psuieee/PoketPomodoro/BOM/BOM - Pomodoro Timer.csv

# | Item | Package Quantity | Quantity Used | Package Cost | Final Unit Cost | Link | Seller | Notes
1 | Attiny 85 | 10 | 1 | $34.00 | $3.40 | https://www.amazon.com/10Pair-ATtiny85-20PU-sockets-Flash-ATtiny85/dp/B0FCYW4XYV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
2 | 128x64 Oled Display | 3 | 1 | $10.00 | $3.33 | https://www.amazon.com/ELEGOO-Display-Compact-Self-Luminous-Projects/dp/B0D2RMQQHR
3 | DS3231 Compact RTC Module | 4 | 1 | $10.00 | $2.50 | https://www.amazon.com/Dorhea-DS3231-Module-Memory-Raspberry/dp/B08X4H3NBR
4 | Push Button | 120 | 5 | $7.00 | $0.29 | https://www.amazon.com/QTEATAK-Momentary-Tactile-Button-Switch/dp/B07VSNN9S2?cv_ct_cx=push%2Bbutton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
5 | Passive Buzzer | 10 | 1 | $4.00 | $0.40 | https://www.amazon.com/Shutao-Passive-Buzzer-12MMx9-5MM-Resistance/dp/B0GKNM192Y
6 | 2k ohm 1% tol resistor |  | 4 |  |  |  |  | Stockroom
7 | 10k ohm 1% tol resistor |  | 1 |  |  |  |  | Stockroom
8 | AAA Battery | 36 | 3 | $13.70 | $1.14 | https://www.amazon.com/Amazon-Basics-AAA-High-Performance-36/dp/B00LH3DMUO
9 | Keystone Battery contacts | 12 | 3 | $5.49 | $1.37 | https://www.amazon.com/Contacts-Negative-Positive-Conversion-Replacement/dp/B0DX1ZXXMG |  | quantity listed in pairs
10 | SS12D00G SPST | 40 | 1 | $7.00 | $0.18 | https://www.amazon.com/SPDT-Mini-Micro-Slide-Switch/dp/B0DN68FJYT?sp_csd=d2lkZ2V0TmFtZT1zcF9hdGY
11 | 4x 15mm M3 Screws | 180 | 4 | $8.54 | $0.19 | https://www.amazon.com/BNUOK-180pcs-Socket-Threads-Spanner/dp/B0DJQGGGJS
12 | 8 pin IC Holder |  | 1 |  |  |  |  | No need, already included with ATtiny85
13 | Male Header Pins | 800 | 4 | $6.29 | $0.03 | https://www.amazon.com/Straight-Breakaway-Connector-Breadboard-Electronic/dp/B0FRZW75VS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 |  | Stockroom
14 | Various Wires |  |  |  |  |  |  | Stockroom
15
16
17
18
19
20
 |  |  |  | $106.02 | $12.84
TO DO:
Add ground plane
Double Check schematics and PCB routing
Remove the power switch terminals
Fix battery cover panel attachment
