psuieee/PoketPomodoro/(commit log)

2026-10-13 Initial README commit with basic overview etc and some structuring along with adding the BOM (as a CSV so github can preview it properly)
    [BOM - Pomodoro Timer.csv]
2026-10-25 pcb steps + pics
2026-10-29 battery wiring steps + pics
2026-10-31 final assembly steps + pics
2026-11-03 Add Arduino code for the ATtiny85 in this code folder
2026-11-03 Add files via upload
    Code for the ATtiny85. Includes the main code and a tester code for the button inputs.
